MatthewHennes/SeniorProject/README.md

# SeniorProject
A battery monitoring system intended to monitor a 216 V battery pack made up of 18 x 12 V batteries.
