MatthewHennes/SeniorProject/0.1/High-Power Circuit Schematic.png

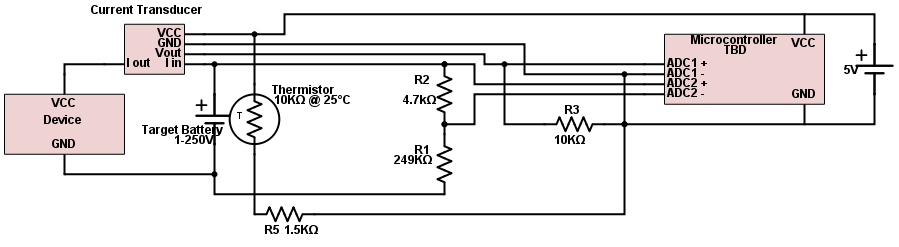
0.1/High-Power Circuit Schematic.png
