MatthewHennes/SeniorProject/0.2/High Power Schematic.png

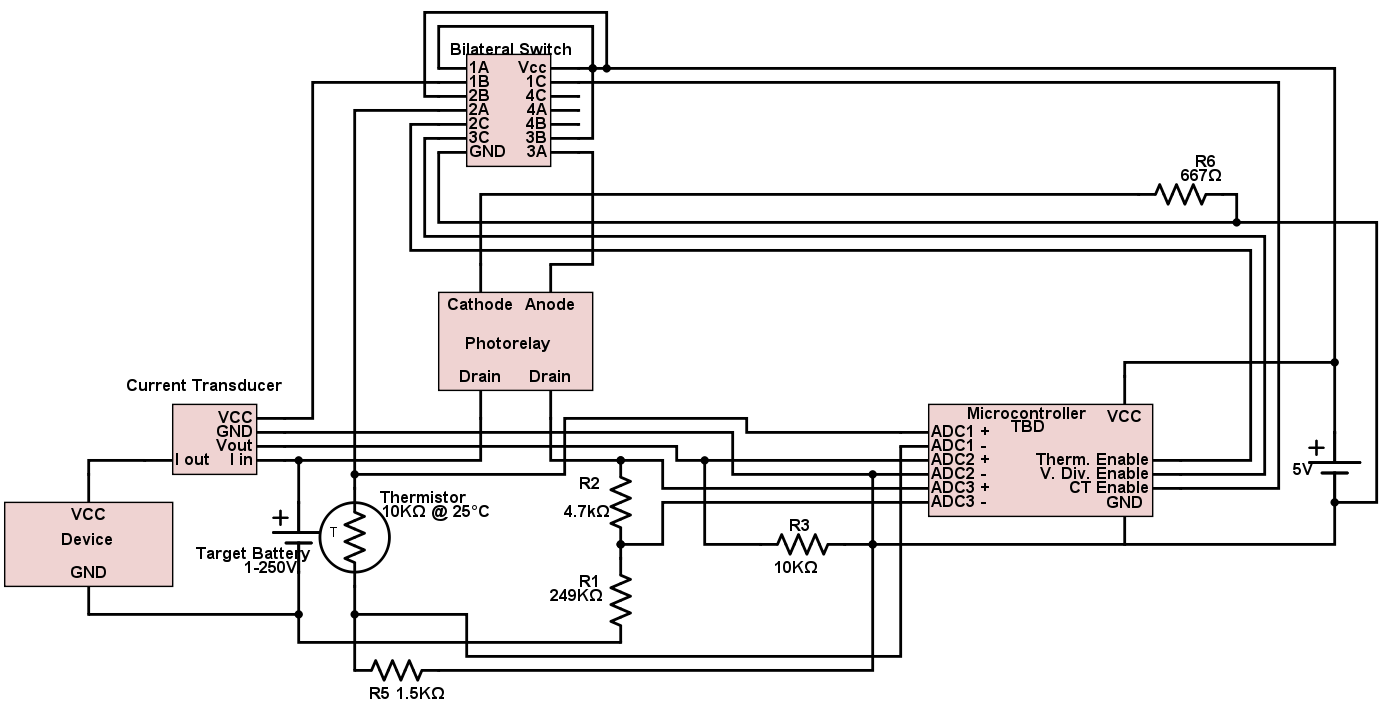
0.2/High Power Schematic.png
