MatthewHennes/SeniorProject/Schematic Cropped-01.jpg

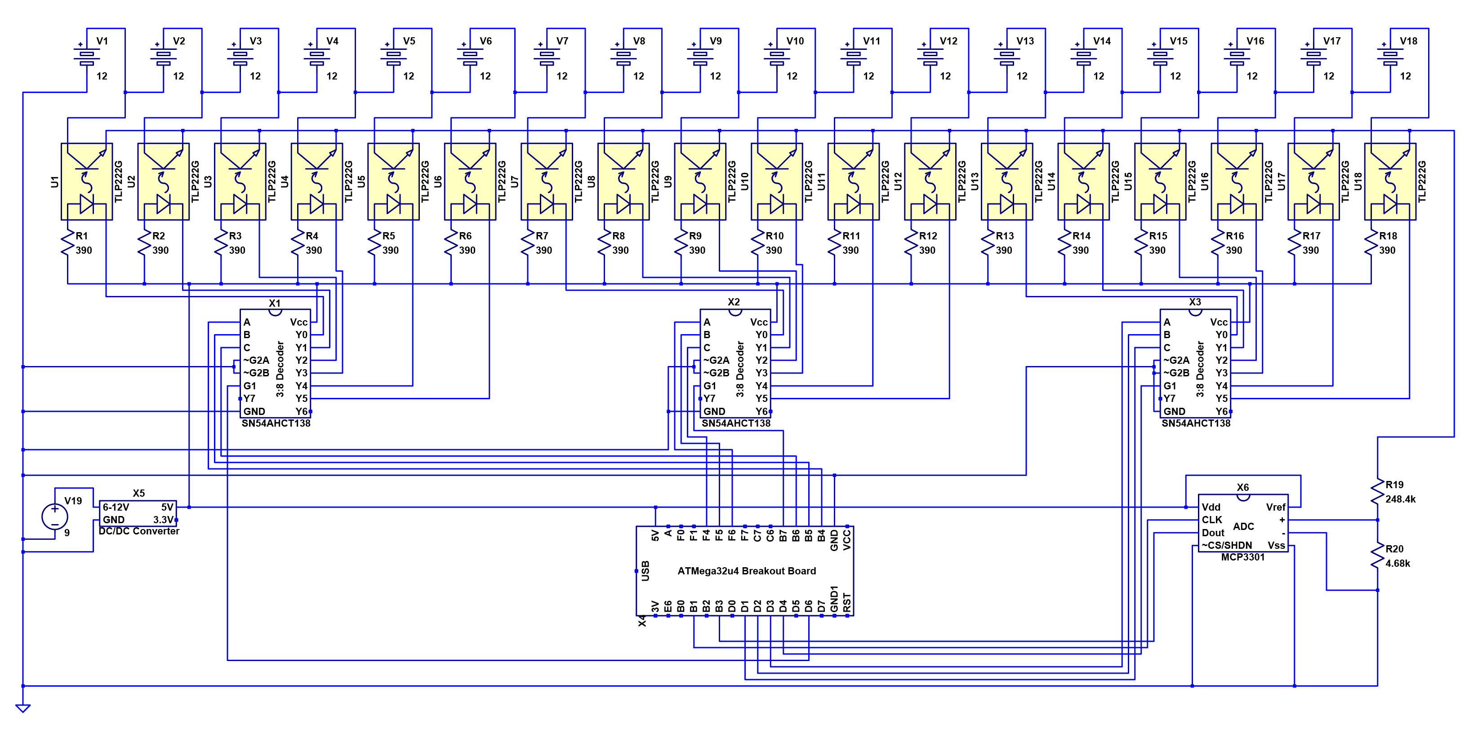
Schematic Cropped-01.jpg
