MatthewHennes/SeniorProject/Schematic Cropped-01.png

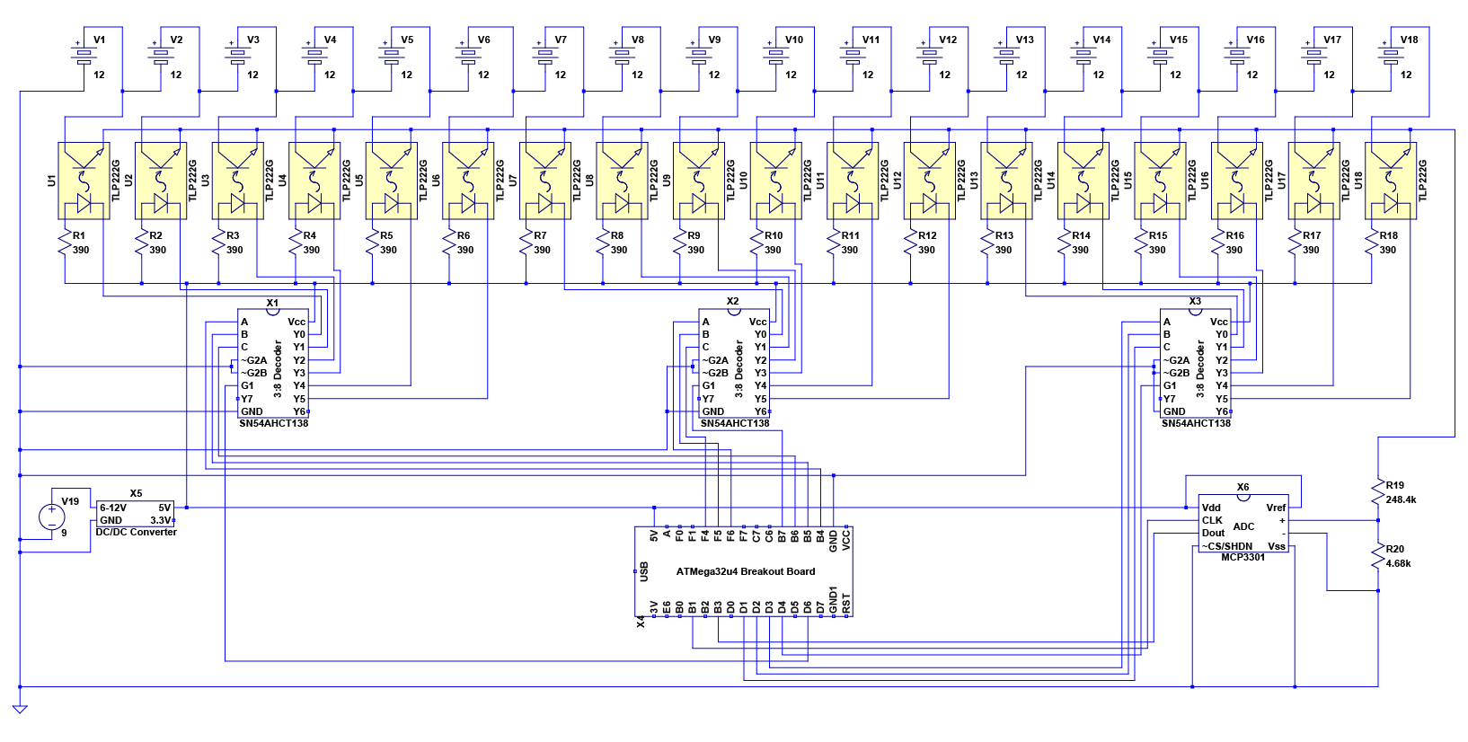
Schematic Cropped-01.png
