MatthewHennes/SeniorProject/Schematic Cropped.png

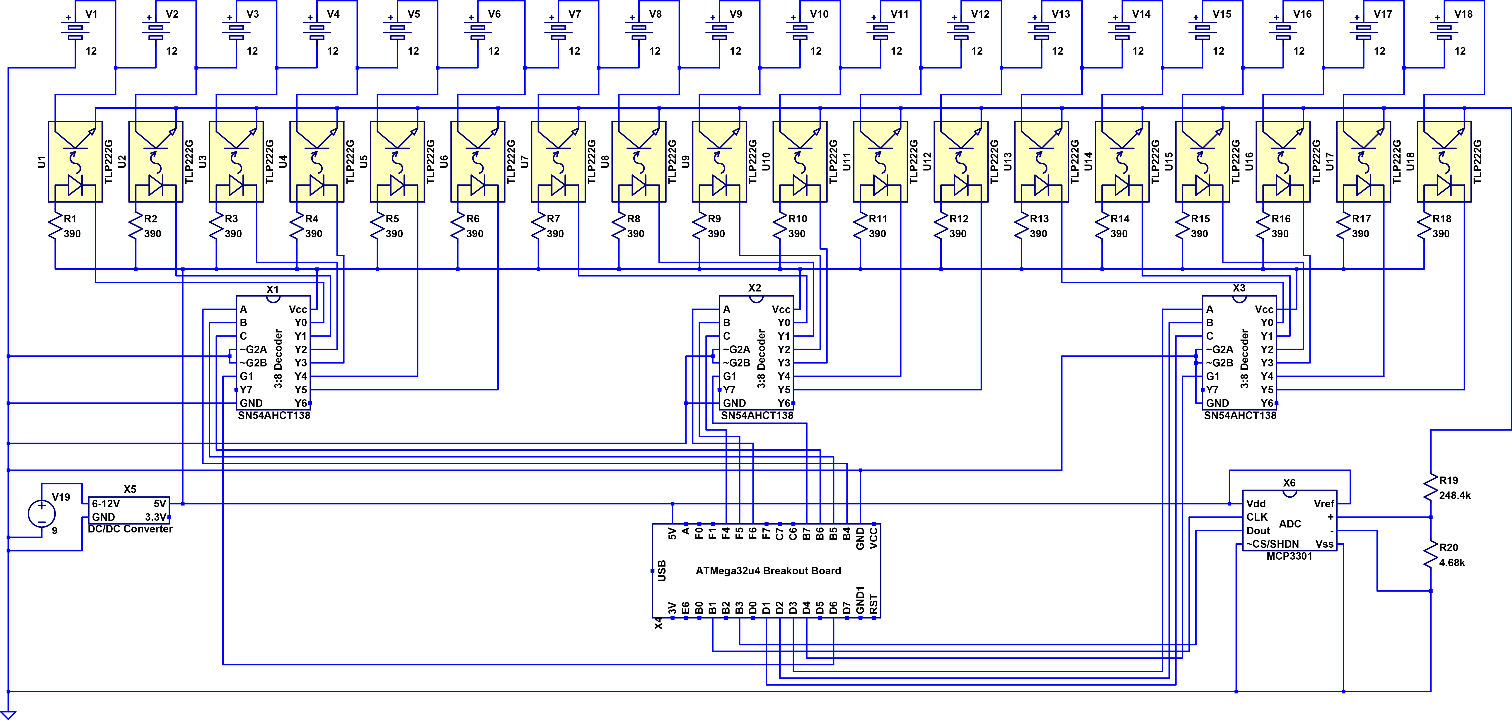
Schematic Cropped.png
