MatthewHennes/SeniorProject/0.1/BOM.xls

RefDes | Name | Value | Manufacturer | Manufacturer Part Number | Digi-Key Part Number | Quantity | Description | Comments
COMP2 | Device |  |  |  |  | 1 | The device being powered
R1 | RESISTOR | 249KÎ© | Vishay Dale | CMF55249K00BEEB | CMF249KHBCT-ND | 1 | RES 249K OHM 1/2W 0.1% AXIAL | Voltage divider, current limiter
R2 | RESISTOR | 4.7kÎ© | Yageo | MFP-25BRD52-4K7 | 4.7KADCT-ND | 1 | RES 4.7K OHM 1/4W 0.1% AXIAL | Measurement resistor
COMP1 | Microcontroller |  | TBD | TBD |  | 1 | Primary controller
COMP3 | Current Transducer |  |  |  | 398-1066-ND or MT7178-ND | 1
R3 | RESISTOR | 10KÎ© |  |  |  | 1 | GENERAL
R4 | Thermistor | 10KÎ© @ 25Â°C | Vishay BC Components | NTCLE100E3103HT1 | BC2395CT-ND | 1 | THERMISTOR NTC 10K 3% RADIAL
R5 |  | 1.5KÎ© |  |  |  | 1 | Current limiter
