MatthewHennes/SeniorProject/Testing.xlsx

 | Run 1
 | Measured | Actual | Error | Error %
Battery 0 | 12.29 | 12.33 | -0.04 | -0.3244120032
Battery 1 | 12.36 | 12.3 | 0.06 | 0.487804878
Battery 2 | 12.36 | 12.3 | 0.06 | 0.487804878
Battery 3 | 12.36 | 12.28 | 0.08 | 0.651465798
Battery 4 | 12.56 | 12.51 | 0.05 | 0.3996802558
Battery 5 | 12.63 | 12.51 | 0.12 | 0.9592326139
Battery 6 | 12.49 | 12.56 | -0.07 | -0.5573248408
Battery 7 | 12.56 | 12.52 | 0.04 | 0.3194888179
Battery 8 | 12.49 | 12.51 | -0.02 | -0.1598721023
Battery 9 | 12.56 | 12.5 | 0.06 | 0.48
Battery 10 | 12.56 | 12.53 | 0.03 | 0.2394253791
Battery 11 | 12.56 | 12.53 | 0.03 | 0.2394253791
Battery 12 | 12.63 | 12.52 | 0.11 | 0.8785942492
Battery 13 | 12.56 | 12.53 | 0.03 | 0.2394253791
Battery 14 | 12.56 | 12.51 | 0.05 | 0.3996802558
Battery 15 | 12.49 | 12.49 | 0 | 0
Battery 16 | 12.56 | 12.55 | 0.01 | 0.0796812749
Battery 17 | 12.56 | 12.53 | 0.03 | 0.2394253791
Average | 12.50777778 | 12.47277778 | 0.035 | 0.2810847551
min | 12.29 | 12.28
max | 12.63 | 12.56
sum | 225.14 | 224.51
