MatthewHennes/SeniorProject/Schematic.pdf

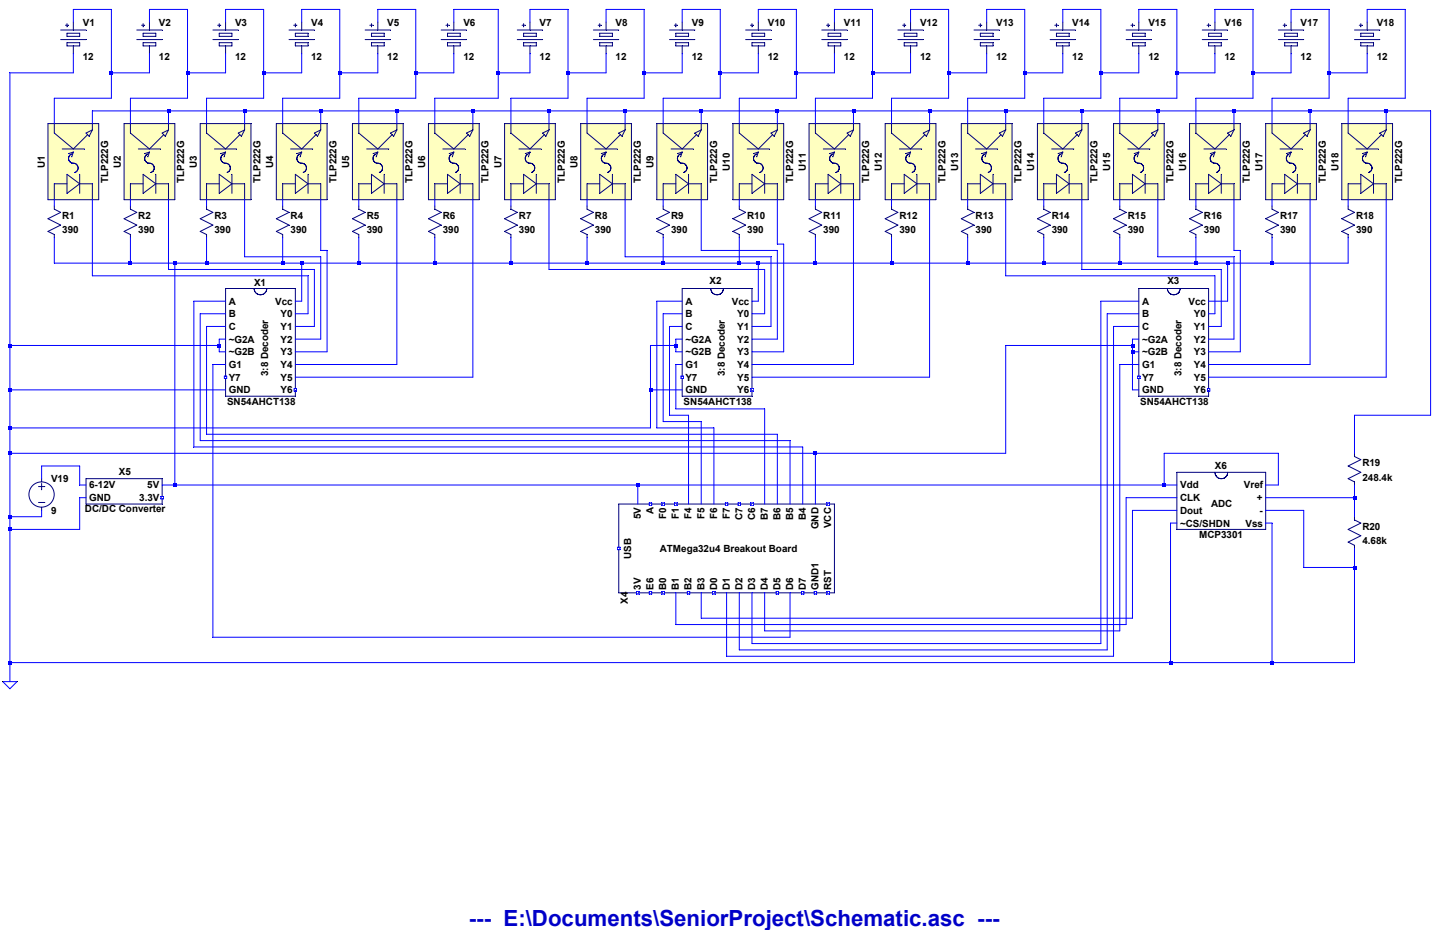
[picture p8: page 1]

--- E:\Documents\SeniorProject\Schematic.asc ---
