MatthewHennes/SeniorProject/Schematic Cropped.pdf

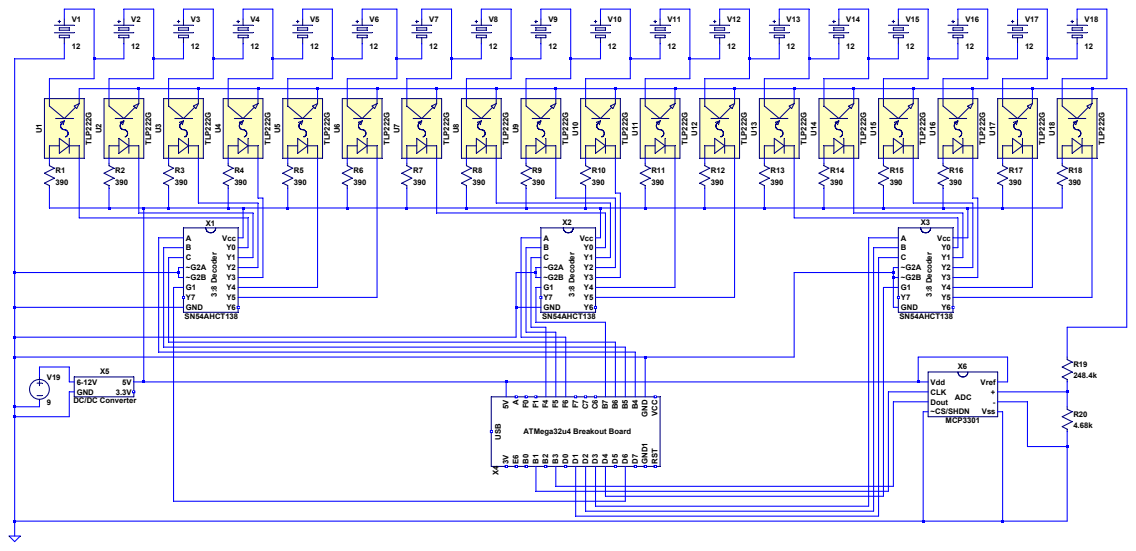
[picture p9: page 1]
