MatthewHennes/SeniorProject/Schematic.asc

R1: res; 390
R2: res; 390
R3: res; 390
R4: res; 390
R5: res; 390
R6: res; 390
R7: res; 390
R8: res; 390
R9: res; 390
R10: res; 390
R11: res; 390
R12: res; 390
R13: res; 390
R14: res; 390
R15: res; 390
R16: res; 390
R17: res; 390
R18: res; 390
R19: res; 248.4k
R20: res; 4.68k
U1: 
U2: 
U3: 
U4: 
U5: 
U6: 
U7: 
U8: 
U9: 
U10: 
U11: 
U12: 
U13: 
U14: 
U15: 
U16: 
U17: 
U18: 
V1: battery; 12
V2: battery; 12
V3: battery; 12
V4: battery; 12
V5: battery; 12
V6: battery; 12
V7: battery; 12
V8: battery; 12
V9: battery; 12
V10: battery; 12
V11: battery; 12
V12: battery; 12
V13: battery; 12
V14: battery; 12
V15: battery; 12
V16: battery; 12
V17: battery; 12
V18: battery; 12
V19: voltage; 9
X1: SN54AHCT138
X2: SN54AHCT138
X3: SN54AHCT138
X4: 
X5: 
X6: MCP3301
Named nets: 0
