MatthewHennes/SeniorProject/(commit log)

2016-06-04 ADC Works
    I can now take measurements with the ADC.
2016-06-05 voltage measurement works
    I can now measure the voltage of all the batteries
2016-06-06 Added files from desktop, and created report document
    [BOM.xls]
2016-06-06 going to check power consumption
2016-06-06 made a software flow diagram
2016-06-06 actually committed the software flow file
2016-06-07 started schematic
2016-06-07 just need to add voltage divider and ADC
2016-06-07 added schematic image
2016-06-07 improved quality of schematic image
2016-06-07 added BoM
2016-06-07 Added test results
    Added an excel spreadsheet with test results
    [Testing.xlsx]
2016-06-07 added testing
    [Testing.xlsx]
2016-06-15 updated caption on hardware overview image
    [Testing.xlsx]
2016-06-15 moved schematic
2016-06-15 talked about #defined resistance values
2016-06-15 updated schematic
2016-06-15 removed a reference to arduino
2016-06-15 added page break between BoM and Testing
2016-06-17 more messing with the schematic
2016-06-21 Slight update to Hardware Overview
    Changed "250V battery" to "250V battery pack."
